sylvaing19/chariot-elevateur-elec/README.md

# chariot-elevateur-elec
Robot's motherboard Eagle files
