sylvaing19/chariot-elevateur-elec/chariot-elevateur.brd

## EAGLE design chariot-elevateur.brd (2019-01-20)

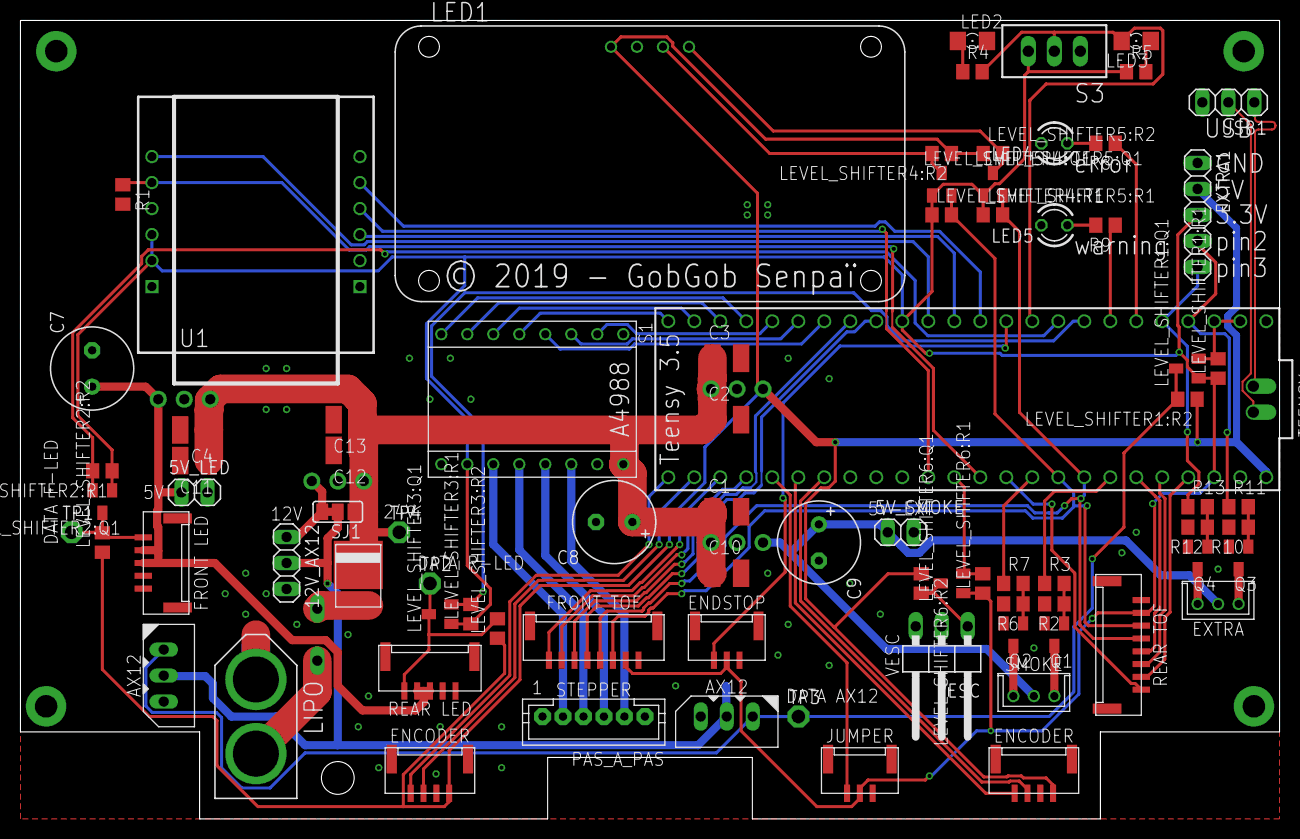
[picture p1: board chariot-elevateur.brd from above]

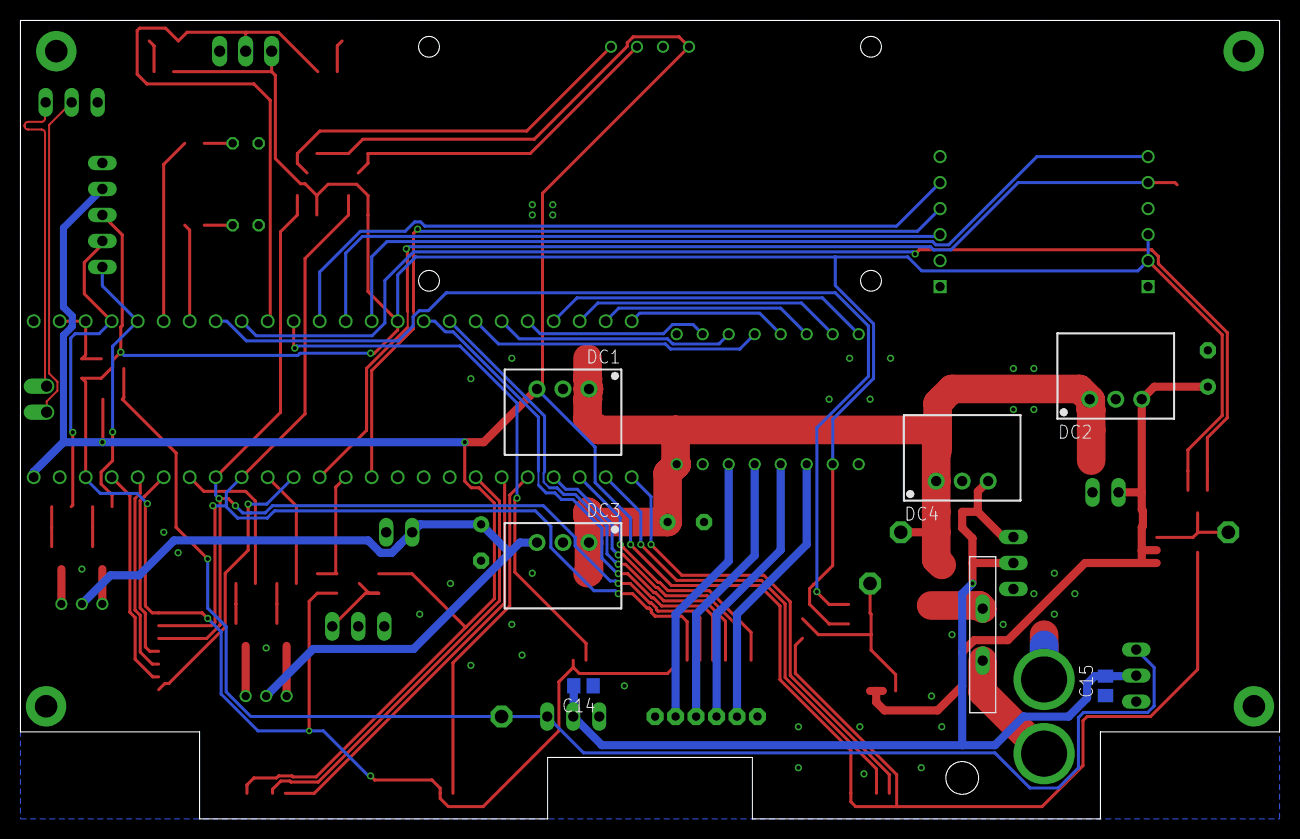
[picture p2: board chariot-elevateur.brd from below]

Board: 2 copper layers, 123.0 x 78.0 mm, 88 parts (7 on the bottom side), 73 nets.

Parts:
5V_LED, 5V_SMOKE: 1X02
12V_AX12: 1X03
AX12_AR, AX12_AV: DYNAMIXEL-1X03AX; DYNAMIXEL_AX_1X03
C1, C2, C3, C4, C10, C11, C12, C13: 10µF/50V; C1210
C7, C9: 220µF/25V; E3,5-8
C8: 100µF/50V; E3,5-8
C14, C15: 1µF; C0805
D1: DIODE_S15P45; TO-277A
DC1, DC2: TSR 1-2450; SIP3
DC3: TSR 2-2450; SIP3
DC4: TSR 2-24120; SIP3
ENCODEUR_DROIT: JST-04GH-V; GH-04-V
ENCODEUR_GAUCHE: JST-04GH-V; GH-04-V
ENDSTOP: JST-03; GH-03-V
EXTRA: DYNAMIXEL-1X03XL; DYNAMIXEL_XL_1X03
EXTRA1: 1X05
FUMIGENE: DYNAMIXEL-1X03XL; DYNAMIXEL_XL_1X03
JUMPER: JST-03; GH-03-V
LED1: ADAFRUIT_7-SEGMENT-LED; 0.56"LED_BACKPACK
LED2: blue; 1206
LED3: orange; 1206
LED4: red; LED3MM
LED5: orange; LED3MM
LEVEL_SHIFTER1:Q1, LEVEL_SHIFTER2:Q1, LEVEL_SHIFTER3:Q1, LEVEL_SHIFTER4:Q1, LEVEL_SHIFTER5:Q1, LEVEL_SHIFTER6:Q1: BSS138; SOT23
LEVEL_SHIFTER1:R1, LEVEL_SHIFTER1:R2, LEVEL_SHIFTER2:R1, LEVEL_SHIFTER2:R2, LEVEL_SHIFTER3:R1, LEVEL_SHIFTER3:R2, LEVEL_SHIFTER4:R1, LEVEL_SHIFTER4:R2, LEVEL_SHIFTER5:R1, LEVEL_SHIFTER5:R2, LEVEL_SHIFTER6:R1, LEVEL_SHIFTER6:R2: 10k; R0805
LIPO: XT-60
P1: RG500; 5MM
PAS_A_PAS: JST-PH6
PHARES_AR: JST-05; GH-05-V
PHARES_AV: JST-05; GH-05-V
Q1, Q2, Q3, Q4: DMN2056U; SOT23
R1, R2, R6, R10, R12: 10k; R0805
R3, R7, R11, R13: 100; R0805
R4, R5, R8, R9: 330; R0805
S1: A4988-BREAKOUT
S3: TL36PO; TL3XPO
SJ1: SJ_2
TEENSY: TEENSY_3.5_DIL+USB
TOF_AR: JST-08; GH-08-V
TOF_AV: JST-08; GH-08-V
TP1, TP2, TP3, TP4: PTR1PAD1-13; P1-13
U1: WIZ820IO; WIZ820
USB1: 1X03
VESC: 1X03/90

Connections:
+3V3: ENDSTOP.2, EXTRA1.3, JUMPER.2, LEVEL_SHIFTER1:Q1.1, LEVEL_SHIFTER1:R1.1, LEVEL_SHIFTER2:Q1.1, LEVEL_SHIFTER2:R1.1, LEVEL_SHIFTER3:Q1.1, LEVEL_SHIFTER3:R1.1, LEVEL_SHIFTER4:Q1.1, LEVEL_SHIFTER4:R1.1, LEVEL_SHIFTER5:Q1.1, LEVEL_SHIFTER5:R1.1, LEVEL_SHIFTER6:Q1.1, LEVEL_SHIFTER6:R1.1, R5.1, S1.VDD, S3.3, TEENSY.3.3V, TEENSY.3.3V3, TOF_AR.2, TOF_AV.2, U1.VIN1, U1.VIN2
+5V/1: DC1.3, ENCODEUR_DROIT.1, ENCODEUR_GAUCHE.1, EXTRA1.2, LED1.VCC, LEVEL_SHIFTER1:R2.1, LEVEL_SHIFTER2:R2.1, LEVEL_SHIFTER3:R2.1, LEVEL_SHIFTER4:R2.1, LEVEL_SHIFTER5:R2.1, LEVEL_SHIFTER6:R2.1, TEENSY.VIN
+5V/2: 5V_LED.1, C7.+, DC2.3, PHARES_AR.3, PHARES_AR.4, PHARES_AV.3, PHARES_AV.4
+5V/3: 5V_SMOKE.1, C9.+, DC3.3, EXTRA.VCC, FUMIGENE.VCC
+12V: 12V_AX12.2, AX12_AR.DYN_VCC, AX12_AV.DYN_VCC, C14.2, C15.2, SJ1.2
+24V: C1.1, C2.1, C3.1, C4.1, C8.+, C10.1, C11.1, C12.1, C13.1, D1.-, DC1.1, DC2.1, DC3.1, DC4.1, S1.VMOT, SJ1.1, TP4.TP
CHOOSE_COLOR: LED3.C, R4.2, S3.2, TEENSY.8
CMD_DEL_AR: LEVEL_SHIFTER3:Q1.2, LEVEL_SHIFTER3:R1.2, TEENSY.6
CMD_DEL_AR_5V: LEVEL_SHIFTER3:Q1.3, LEVEL_SHIFTER3:R2.2, PHARES_AR.5, TP2.TP
CMD_DEL_AV: LEVEL_SHIFTER2:Q1.2, LEVEL_SHIFTER2:R1.2, TEENSY.7
CMD_DEL_AV_5V: LEVEL_SHIFTER2:Q1.3, LEVEL_SHIFTER2:R2.2, PHARES_AV.5, TP1.TP
CMD_FUM_POMPE: R3.1, TEENSY.20/A6
CMD_FUM_RES: R7.1, TEENSY.17/A3
DEL_ERROR: R8.1, TEENSY.4
DEL_WARNING: R9.1, TEENSY.5
DIR: S1.DIR, TEENSY.29
ENC_D_A: ENCODEUR_DROIT.3, TEENSY.39/A20
ENC_D_B: ENCODEUR_DROIT.4, TEENSY.38/A19
ENC_G_A: ENCODEUR_GAUCHE.3, TEENSY.34/A15
ENC_G_B: ENCODEUR_GAUCHE.4, TEENSY.33/A14
ENDSTOP: ENDSTOP.3, TEENSY.9
ETH_MISO: TEENSY.12, U1.MISO
ETH_MOSI: TEENSY.11, U1.MOSI
ETH_RST: R1.1, TEENSY.15/A1, U1.RESET
ETH_SCLK: TEENSY.13, U1.SCLK
ETH_SS: TEENSY.10, U1.SS
EXTRA_GPIO_1: EXTRA1.4, R11.1, TEENSY.2
EXTRA_GPIO_2: EXTRA1.5, R13.1, TEENSY.3
EXTRA_POWER_SWITCH_1: EXTRA.GND, Q3.3
EXTRA_POWER_SWITCH_2: EXTRA.DATA, Q4.3
FUM_POMPE: FUMIGENE.GND, Q1.3
FUM_RES: FUMIGENE.DATA, Q2.3
GND: 5V_LED.2, 5V_SMOKE.2, 12V_AX12.3, AX12_AR.GND, AX12_AV.GND, C1.2, C2.2, C3.2, C4.2, C7.-, C8.-, C9.-, C10.2, C11.2, C12.2, C13.2, C14.1, C15.1, DC1.2, DC2.2, DC3.2, DC4.2, ENCODEUR_DROIT.2, ENCODEUR_GAUCHE.2, ENDSTOP.1, EXTRA1.1, JUMPER.1, LED1.GND, LED2.C, LED4.K, LED5.K, LIPO.(-), PHARES_AR.1, PHARES_AR.2, PHARES_AV.1, PHARES_AV.2, Q1.2, Q2.2, Q3.2, Q4.2, R1.2, R2.2, R6.2, R10.2, R12.2, S1.GND1, S1.GND2, S3.1, TEENSY.AGND, TEENSY.GND, TEENSY.GND1, TOF_AR.1, TOF_AV.1, U1.GND1, U1.GND2, U1.GND3, U1.PWDN, USB1.3, VESC.3
JUMPER: JUMPER.3, TEENSY.37/A18
unnamed: LED4.A, R8.2
unnamed: PAS_A_PAS.2, S1.1B
unnamed: PAS_A_PAS.3, S1.1A
unnamed: D1.+1, D1.+2, P1.P$1
unnamed: PAS_A_PAS.4, S1.2A
unnamed: PAS_A_PAS.5, S1.2B
unnamed: LED2.A, R4.1
unnamed: LED3.A, R5.2
unnamed: Q3.1, R10.1, R11.2
unnamed: Q1.1, R2.1, R3.2
unnamed: LED5.A, R9.2
unnamed: Q4.1, R12.1, R13.2
unnamed: Q2.1, R6.1, R7.2
REG_12V: 12V_AX12.1, DC4.3, SJ1.3
SCL: LEVEL_SHIFTER5:Q1.2, LEVEL_SHIFTER5:R1.2, TEENSY.19/A5, TOF_AR.4, TOF_AV.4
SCL_5V: LED1.SCL, LEVEL_SHIFTER5:Q1.3, LEVEL_SHIFTER5:R2.2
SDA: LEVEL_SHIFTER4:Q1.2, LEVEL_SHIFTER4:R1.2, TEENSY.18/A4, TOF_AR.3, TOF_AV.3
SDA_5V: LED1.SDA, LEVEL_SHIFTER4:Q1.3, LEVEL_SHIFTER4:R2.2
SERIAL_AX12: LEVEL_SHIFTER1:Q1.2, LEVEL_SHIFTER1:R1.2, TEENSY.0, TEENSY.1
SERIAL_AX12_5V: AX12_AR.DATA, AX12_AV.DATA, LEVEL_SHIFTER1:Q1.3, LEVEL_SHIFTER1:R2.2, TP3.TP
STEP: S1.STEP, TEENSY.30
S_MS1: S1.MS1, TEENSY.28
S_MS2: S1.MS2, TEENSY.27
S_MS3: S1.MS3, TEENSY.26
S_N_RST: S1.N_RST, TEENSY.32/A13
S_N_SLEEP: S1.N_SLEEP, TEENSY.31/A12
TOF_AR_D: TEENSY.23/A9, TOF_AR.7
TOF_AR_FD: TEENSY.16/A2, TOF_AR.8
TOF_AR_FG: TEENSY.21/A7, TOF_AR.5
TOF_AR_G: TEENSY.22/A8, TOF_AR.6
TOF_AV_D: TEENSY.35/A16, TOF_AV.8
TOF_AV_G: TEENSY.24, TOF_AV.5
TOF_AV_SD: TEENSY.36/A17, TOF_AV.7
TOF_AV_SG: TEENSY.25, TOF_AV.6
USB_D+: TEENSY.USBD+, USB1.1
USB_D-: TEENSY.USBD-, USB1.2
VESC_CMD: LEVEL_SHIFTER6:Q1.2, LEVEL_SHIFTER6:R1.2, TEENSY.14/A0
VESC_CMD_5V: LEVEL_SHIFTER6:Q1.3, LEVEL_SHIFTER6:R2.2, VESC.1
V_LIPO: LIPO.(+), P1.P$2
