sylvaing19/chariot-elevateur-elec/rpi-shield.brd

## EAGLE design rpi-shield.brd (2019-01-20)

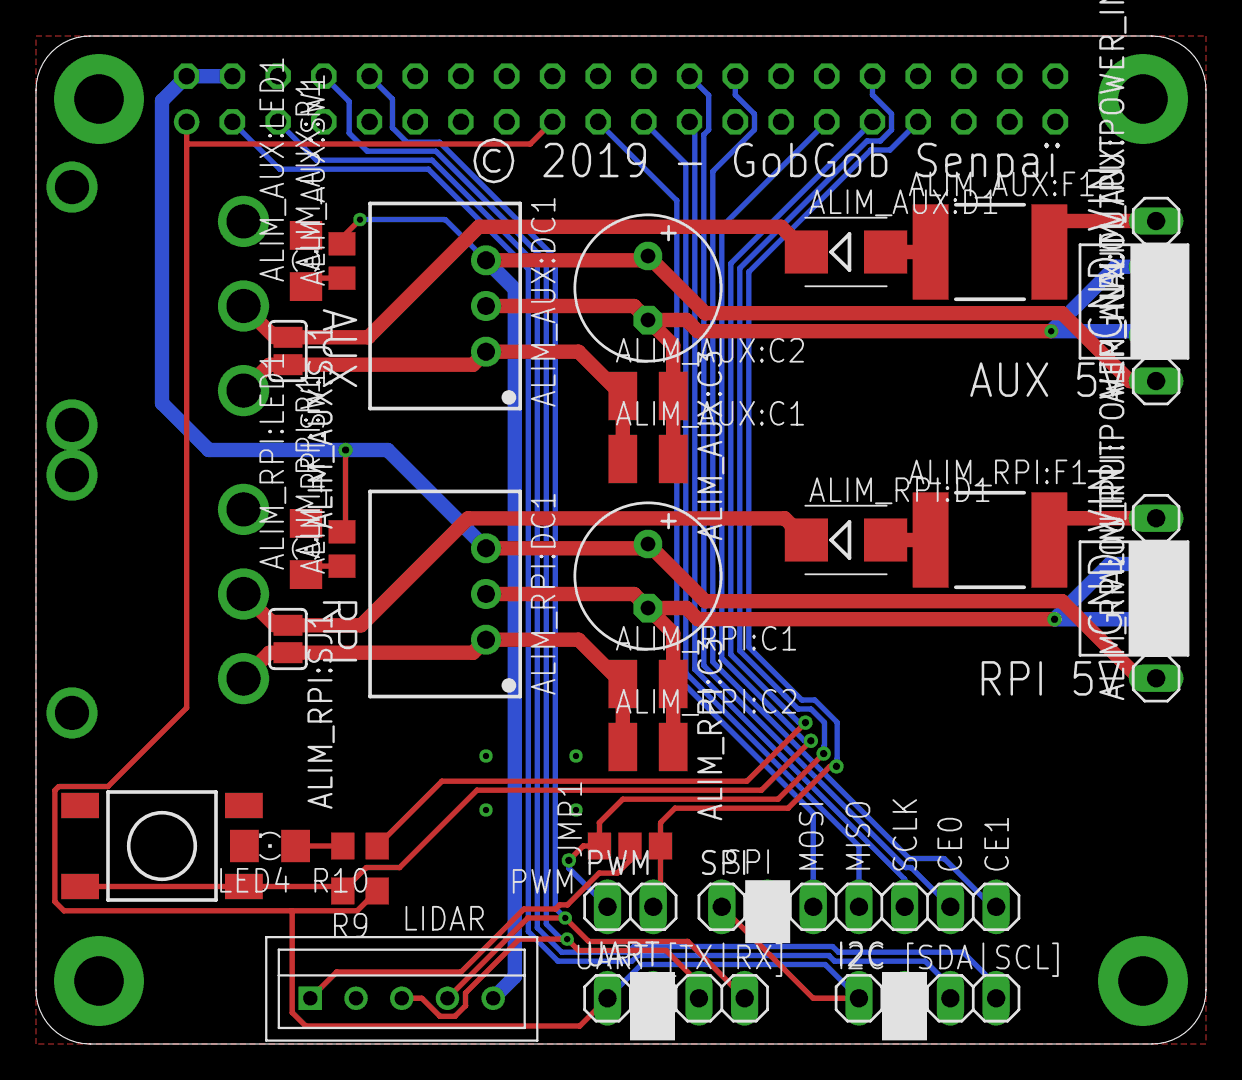
[picture p3: board rpi-shield.brd from above]

Board: 2 copper layers, 65.0 x 56.0 mm, 35 parts (1 on the bottom side), 29 nets.

Parts:
ALIM_AUX:C1, ALIM_AUX:C2: 10µF/50V; C1210
ALIM_AUX:C3: 220µF/25V; E3,5-8
ALIM_AUX:D1: SS56B; SMB
ALIM_AUX:DC1: TSR 2-2450; SIP3
ALIM_AUX:F1: MF-LSMF300
ALIM_AUX:LED1: blue; 1206
ALIM_AUX:OUTPUT: 1X02
ALIM_AUX:POWER_INPUT: 1X02
ALIM_AUX:R1: 470; R0805
ALIM_AUX:SJ1: SJ
ALIM_AUX:SW1: 5MS1S102AM6QES; SPDT_SLIDE_SWITCH
ALIM_RPI:C1, ALIM_RPI:C2: 10µF/50V; C1210
ALIM_RPI:C3: 220µF/25V; E3,5-8
ALIM_RPI:D1: SS56B; SMB
ALIM_RPI:DC1: TSR 2-2450; SIP3
ALIM_RPI:F1: MF-LSMF300
ALIM_RPI:LED1: blue; 1206
ALIM_RPI:OUTPUT: 1X02
ALIM_RPI:POWER_INPUT: 1X02
ALIM_RPI:R1: 470; R0805
ALIM_RPI:SJ1: SJ
ALIM_RPI:SW1: 5MS1S102AM6QES; SPDT_SLIDE_SWITCH
I2C: 1X04
JMP1: 0R-JUMPA; A0R-JMP
LED4: red; 1206
LIDAR: 05-JST-B5B-XH-A; B5B-XH
PWM: 1X02
R9: 10k; R0805
R10: 330; R0805
SPI: 1X07
SV1: FE20-2
U$2: PUSH-BUTTON
UART: 1X04

Connections:
+3V3: I2C.1, R9.1, SPI.1, SV1.1, SV1.17, UART.1
+5V: ALIM_RPI:C3.+, ALIM_RPI:DC1.3, ALIM_RPI:OUTPUT.1, ALIM_RPI:R1.2, SV1.2, SV1.4
+5V/1: ALIM_AUX:C3.+, ALIM_AUX:DC1.3, ALIM_AUX:OUTPUT.1, ALIM_AUX:R1.2, LIDAR.P$5
ALIM_AUX:N$1: ALIM_AUX:C1.1, ALIM_AUX:C2.1, ALIM_AUX:DC1.1, ALIM_AUX:SJ1.2, ALIM_AUX:SW1.1
ALIM_AUX:N$3: ALIM_AUX:LED1.A, ALIM_AUX:R1.1
ALIM_AUX:N$4: ALIM_AUX:D1.C, ALIM_AUX:SJ1.1, ALIM_AUX:SW1.C
ALIM_AUX:N$6: ALIM_AUX:D1.A, ALIM_AUX:F1.1
ALIM_AUX:N$7: ALIM_AUX:F1.2, ALIM_AUX:POWER_INPUT.2
ALIM_RPI:N$1: ALIM_RPI:C1.1, ALIM_RPI:C2.1, ALIM_RPI:DC1.1, ALIM_RPI:SJ1.2, ALIM_RPI:SW1.1
ALIM_RPI:N$3: ALIM_RPI:LED1.A, ALIM_RPI:R1.1
ALIM_RPI:N$4: ALIM_RPI:D1.C, ALIM_RPI:SJ1.1, ALIM_RPI:SW1.C
ALIM_RPI:N$6: ALIM_RPI:D1.A, ALIM_RPI:F1.1
ALIM_RPI:N$7: ALIM_RPI:F1.2, ALIM_RPI:POWER_INPUT.2
CE0: SPI.6, SV1.24
CE1: SPI.7, SV1.26
GND: ALIM_AUX:C1.2, ALIM_AUX:C2.2, ALIM_AUX:C3.-, ALIM_AUX:DC1.2, ALIM_AUX:LED1.C, ALIM_AUX:OUTPUT.2, ALIM_AUX:POWER_INPUT.1, ALIM_AUX:SW1.P$4, ALIM_AUX:SW1.P$5, ALIM_RPI:C1.2, ALIM_RPI:C2.2, ALIM_RPI:C3.-, ALIM_RPI:DC1.2, ALIM_RPI:LED1.C, ALIM_RPI:OUTPUT.2, ALIM_RPI:POWER_INPUT.1, ALIM_RPI:SW1.P$4, ALIM_RPI:SW1.P$5, I2C.2, LED4.C, LIDAR.P$2, SPI.2, SV1.6, SV1.9, SV1.14, SV1.20, SV1.25, SV1.30, SV1.34, SV1.39, U$2.1, U$2.2, UART.2
MISO: SPI.4, SV1.21
MOSI: SPI.3, SV1.19
unnamed: JMP1.2, LIDAR.P$1
unnamed: R9.2, SV1.29, U$2.3, U$2.4
unnamed: R10.1, SV1.31
unnamed: LED4.A, R10.2
PWM0: JMP1.1, PWM.1, SV1.32
PWM1: JMP1.3, PWM.2, SV1.33
RX: LIDAR.P$4, SV1.10, UART.4
SCL: I2C.4, SV1.5
SCLK: SPI.5, SV1.23
SDA: I2C.3, SV1.3
TX: LIDAR.P$3, SV1.8, UART.3
