sylvaing19/chariot-elevateur-elec/(commit log)

2018-12-17 Board dimensions
    [chariot-elevateur.brd, chariot-elevateur.sch]
2018-12-17 Placement des gros composants
    [chariot-elevateur.brd, chariot-elevateur.sch, pin-mapping.xlsx]
2018-12-18 more components
    [chariot-elevateur.brd, chariot-elevateur.sch]
2018-12-19 Add power connector
    [chariot-elevateur.brd, chariot-elevateur.sch]
2018-12-19 placement connecteurs
    [chariot-elevateur.brd, chariot-elevateur.sch]
2018-12-28 end-of-the-day commit
    [chariot-elevateur.brd, chariot-elevateur.sch]
2018-12-28 end-of-day commit
    [chariot-elevateur.brd, chariot-elevateur.sch, pin-mapping.xlsx]
2018-12-31 Update components ref + add debug LEDs + map unused pins for debug
    [chariot-elevateur.brd, chariot-elevateur.sch]
2018-12-31 add BOM
    [chariot-elevateur-bom.xlsx, chariot-elevateur.csv]
2019-01-07 new file for rpi shield
    [chariot-elevateur.brd, chariot-elevateur.sch, raspi.brd, raspi.sch]
2019-01-08 shield raspi: shematics done
    [raspi.brd, raspi.sch]
2019-01-08 rename rpi shield file
    [rpi-shield.brd, rpi-shield.sch]
2019-01-09 placement composants rpi-shield
    [rpi-shield.brd]
2019-01-10 add debug features
    [chariot-elevateur.brd, chariot-elevateur.sch]
2019-01-11 all done, missing doc
    [chariot-elevateur.brd, chariot-elevateur.sch, rpi-shield.brd, rpi-shield.sch]
2019-01-11 CAM files are ready
    [chariot-elevateur.brd, chariot-elevateur.sch, rpi-shield.brd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]
2019-01-11 FAB version
    [fab-chariot-elevateur.brd, fab-chariot-elevateur.sch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]
2019-01-12 maj BOM
    [Bill-Of-Materials.xlsx, fab-chariot-elevateur.brd, fab-chariot-elevateur.csv, fab-chariot-elevateur.sch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]
2019-01-20 push eagle boards to fusion
    [chariot-elevateur.brd, rpi-shield.brd]
