sylvaing19/chariot-elevateur-elec/(notices)

Notices in the files:
rpi-shield.brd:
© 2019 - GobGob Senpaï
